ElPopularVale/LDL1A/README.md

Life Data Link vital signs monitor project files.
