ElPopularVale/LDL1A/Lifedatalink_v1_revA.kicad_pcb

## KiCad design Lifedatalink_v1_revA.kicad_pcb (2020-07-07)

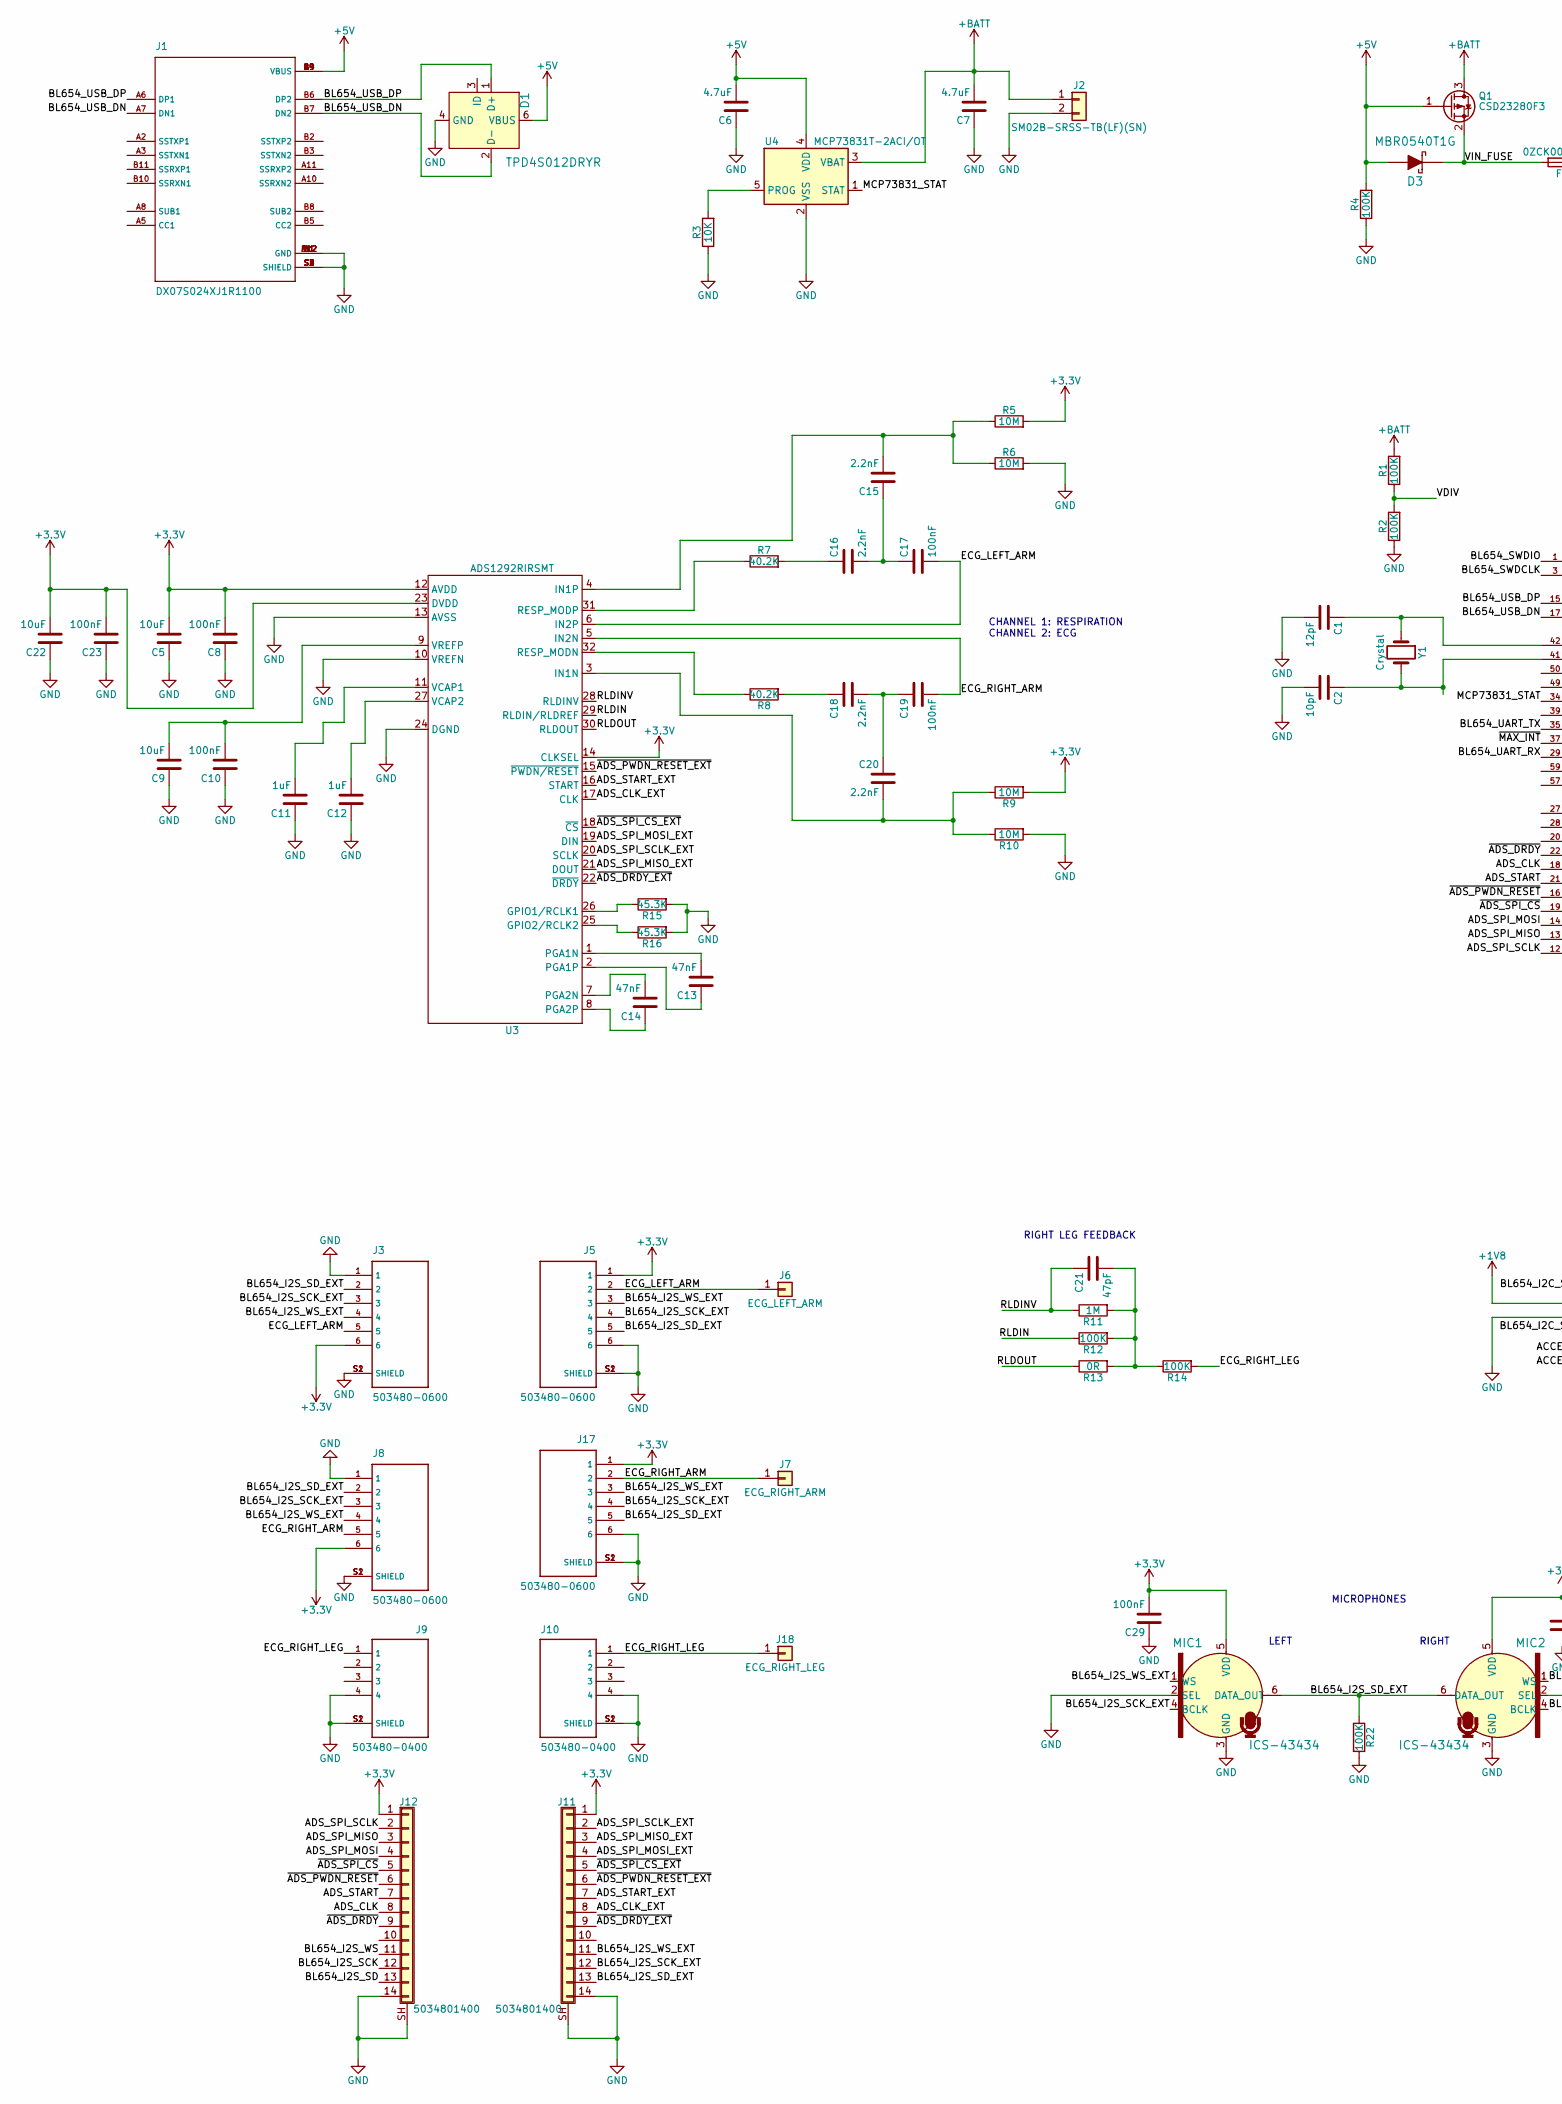
[picture p1: schematic Lifedatalink_v1_revA.kicad_sch, LifeDataLink, part in row 1, column 1]

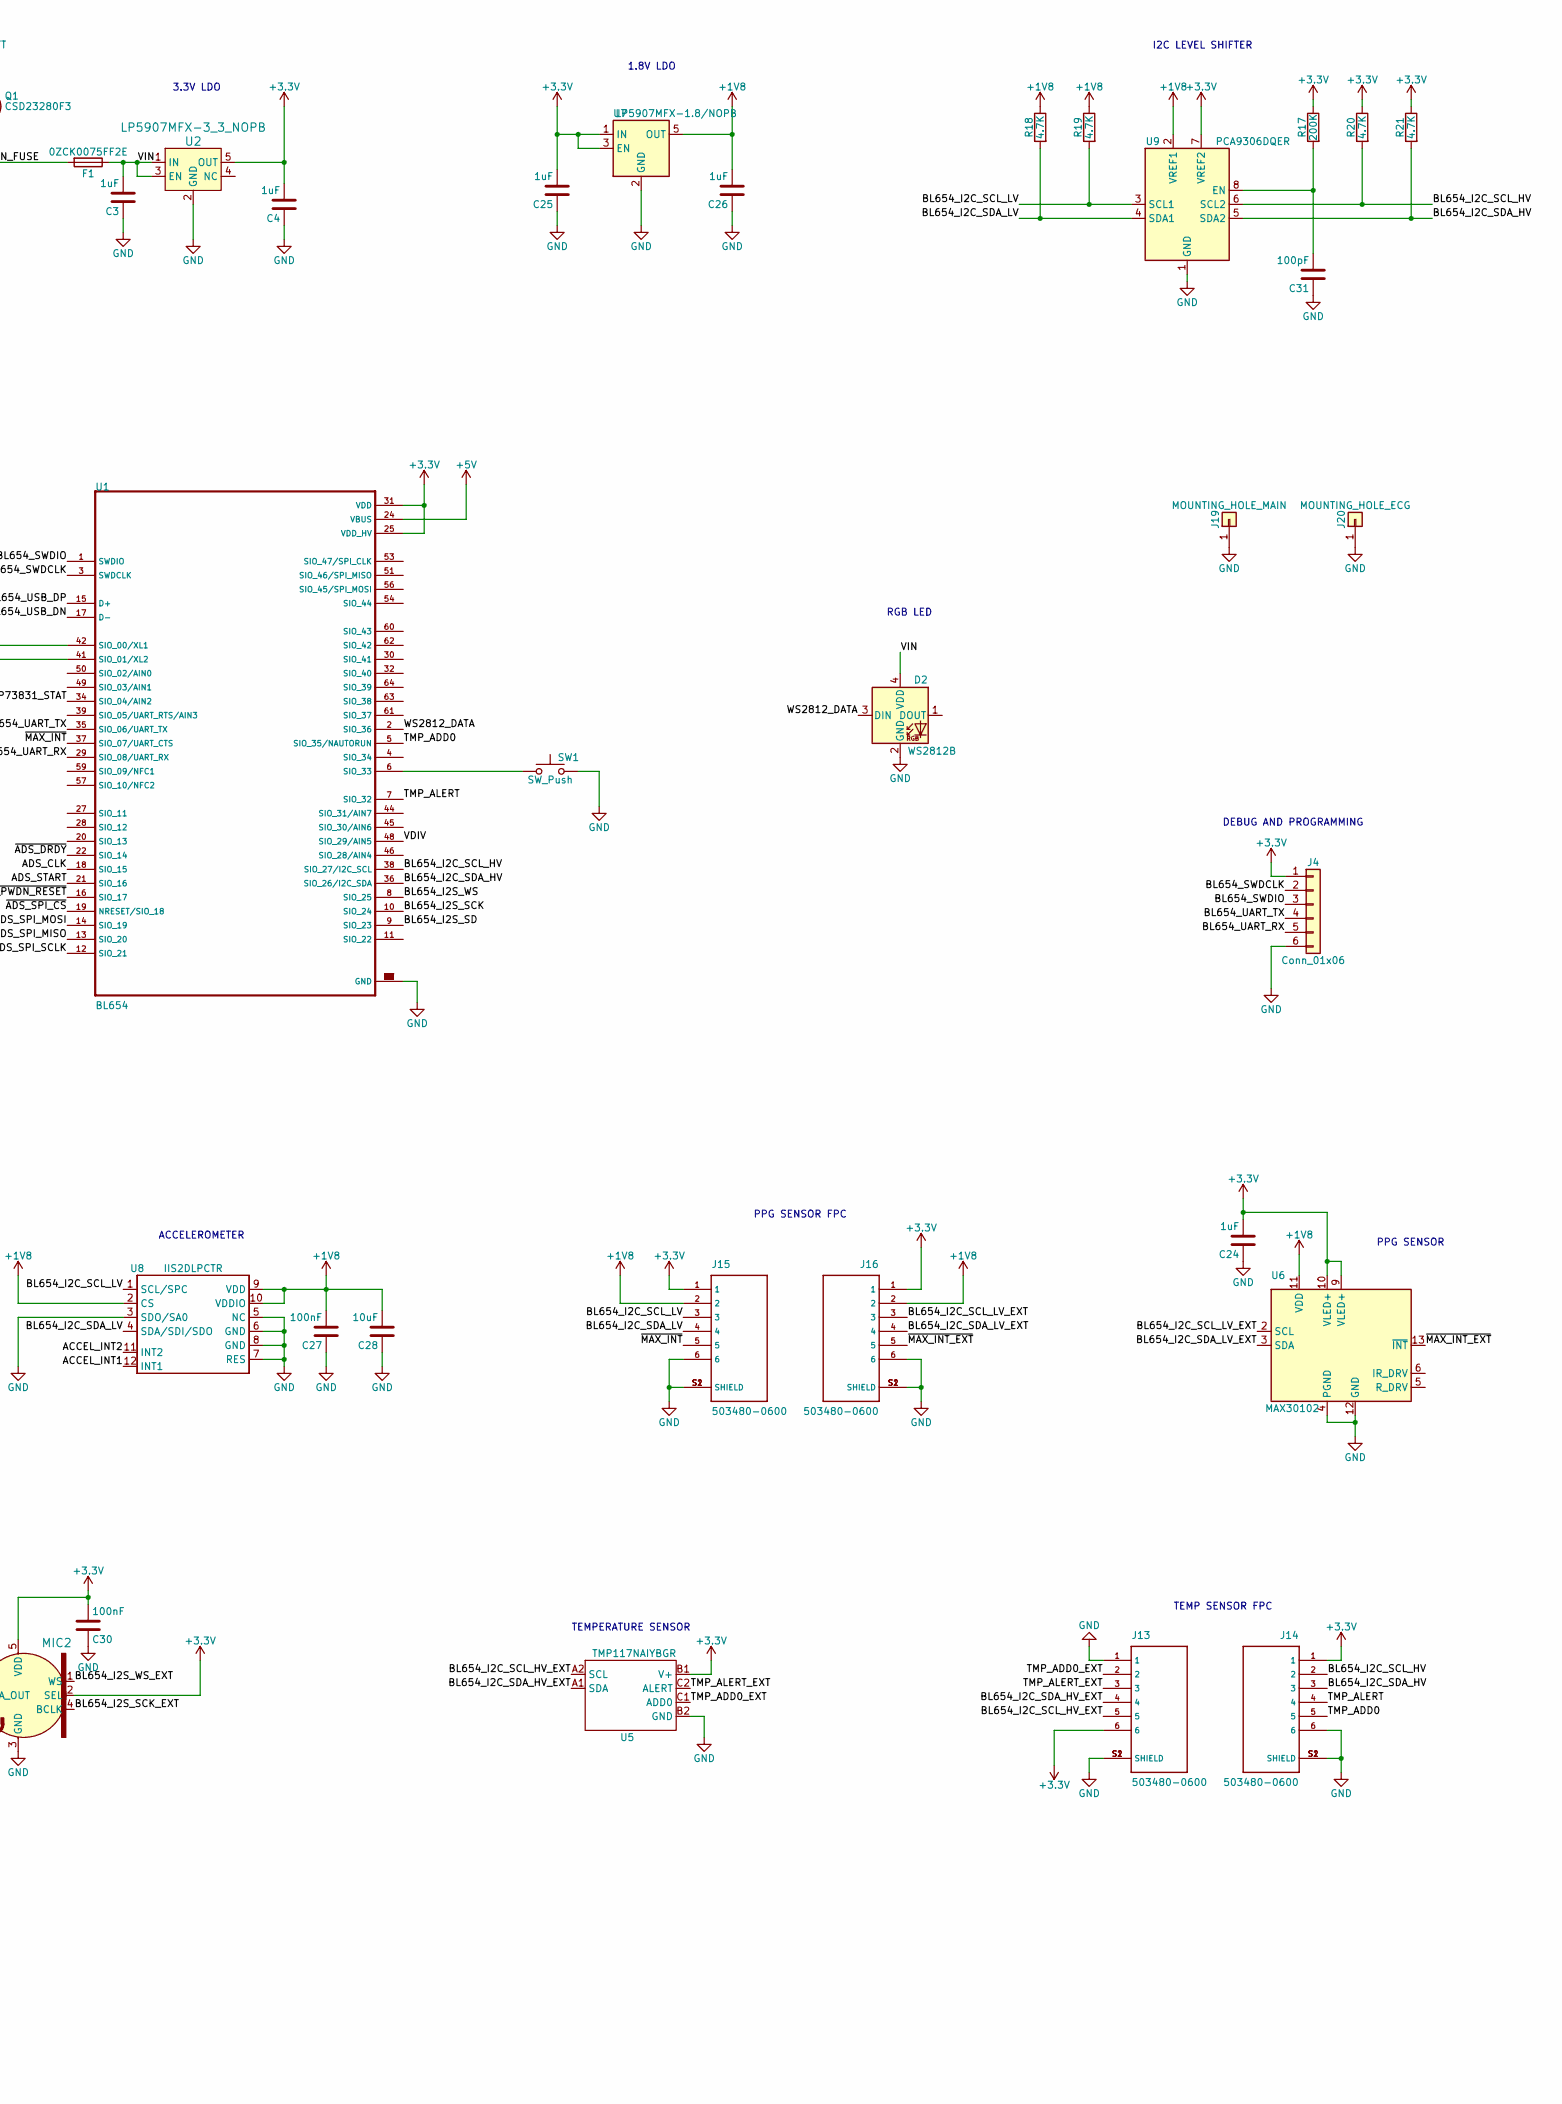
[picture p2: schematic Lifedatalink_v1_revA.kicad_sch, LifeDataLink, part in row 1, column 2]

Parts:
C1: 12pF; C_0402_1005Metric; MPN C0402C120J5GACTU
C2: 10pF; C_0402_1005Metric; MPN C0402C100J5GACTU
C3, C4, C11, C12, C24, C25, C26: 1uF; C_0402_1005Metric; MPN C0402C105K9PACTU
C5, C9, C22, C28: 10uF; C_0402_1005Metric; MPN C0402C106M9PAC7867
C6, C7: 4.7uF; C_0402_1005Metric; MPN C0402C475M7PACTU
C8, C10, C17, C19, C23, C27, C29, C30: 100nF; C_0402_1005Metric; MPN C0402C104K4PACTU
C13, C14: 47nF; C_0402_1005Metric; MPN C0402C473K3RACAUTO
C15, C16, C18, C20: 2.2nF; C_0402_1005Metric; MPN C0402C222K5RACTU
C21: 47pF; C_0402_1005Metric; MPN C0402C470K5GACTU
C31: 100pF; C_0402_1005Metric; MPN C0402C101J5GACTU
D1: TPD4S012DRYR; SON50P100X145X60-6N; MPN TPD4S012DRYR; Digi-Key_PN 296-24244-1-ND
D2: WS2812B; LED_WS2812-2020; MPN APA-102-2020
D3: MBR0540T1G; D_SOD-123; MPN MBR0540T1G; Digi-Key_PN MBR0540T1GOSCT-ND
F1: 0ZCK0075FF2E; Fuse_0805_2012Metric; MPN 0603L075SLYR
J1: DX07S024XJ1R1100; JAE_DX07S024XJ1R1100; MPN DX07S024XJ1R1100
J2: SM02B-SRSS-TB(LF)(SN); JST_SH_SM02B-SRSS-TB_1x02-1MP_P1.00mm_Horizontal; MPN SM02B-SRSS-TB(LF)(SN)
J3, J5, J8, J13, J14, J15, J16, J17: 503480-0600; MOLEX_503480-0600; MPN 503480-0600
J4: Conn_01x06; 1.27mm_pads_01x06
J6: ECG_LEFT_ARM; ECG_SNAP
J7: ECG_RIGHT_ARM; ECG_SNAP
J9, J10: 503480-0400; MOLEX_503480-0400; MPN 503480-0400
J11, J12: 5034801400; MPN 503480-1400
J18: ECG_RIGHT_LEG; ECG_SNAP
J19: MOUNTING_HOLE_MAIN; MountingHole_2.2mm_M2_DIN965_Pad
J20: MOUNTING_HOLE_ECG; MountingHole_2.2mm_M2_DIN965_Pad
MIC1, MIC2: ICS-43434; SPH0645LM4H-B; MPN ICS-43434
Q1: CSD23280F3; TRANS_CSD23280F3; MPN CSD23280F3
R1, R2, R4, R12, R14, R22: 100K; R_0402_1005Metric; MPN CRCW0402100KFKEDC
R3: 10K; R_0402_1005Metric; MPN CRCW040210K0FKEDC
R5, R6, R9, R10: 10M; R_0402_1005Metric; MPN CRCW040210M0FKED
R7, R8: 40.2K; R_0402_1005Metric; MPN CRCW040240K2FKEDC
R11: 1M; R_0402_1005Metric; MPN CRCW04021M00FKEDC
R13: 0R; R_0402_1005Metric; MPN CRCW04020000Z0EDC
R15, R16: 45.3K; R_0402_1005Metric; MPN RC0402FR-0745K3L
R17: 200K; R_0402_1005Metric; MPN RC0402FR-07200KL
R18, R19, R20, R21: 4.7K; R_0402_1005Metric; MPN CRCW04024K70FKEDC
SW1: SW_Push; SW_B3U-3000P; MPN B3U-3000P
U1: BL654; XCVR_451-00001; MPN BL654
U2: LP5907MFX-3_3_NOPB; SOT-23-5; MPN LP5907MFX-3.3/NOPB; Digi-Key_PN 296-38557-1-ND
U3: ADS1292RIRSMT; QFN-32-1EP_4x4mm_P0.4mm_EP2.9x2.9mm; MPN ADS1292RIRSMT
U4: MCP73831T-2ACI/OT; SOT-23-5; MPN MCP73831T-2ACI/OT
U5: TMP117NAIYBGR; Texas_DSBGA-6_0.9x1.4mm_Layout2x3_P0.5mm; MPN TMP117NAIYBGR
U6: MAX30102; Maxim_OLGA-14_3.3x5.6mm_P0.8mm; MPN MAX30102EFD+
U7: LP5907MFX-1.8/NOPB; SOT-23-5; MPN LP5907MFX-1.8/NOPB
U8: IIS2DLPCTR; LGA-12_2x2mm_P0.5mm; MPN IIS2DLPCTR
U9: PCA9306DQER; X2SON-8_1.4x1mm_P0.35mm; MPN PCA9306DQER
Y1: Crystal; ABS05-32.768KHZ-T; MPN ABS05-32.768KHZ-9-T

Connections:
+1V8: C26.2, C27.2, C28.2, J15.2, J16.2, R18.1, R19.1, U6.11 (VDD), U7.5 (OUT), U8.2 (CS), U8.9 (VDD), U8.10 (VDDIO), U9.2 (VREF1)
+3V3: C4.2, C5.2, C8.2, C22.2, C23.2, C24.2, C25.2, C29.2, C30.2, J3.6, J4.1, J5.1, J8.6, J11.1, J12.1, J13.6, J14.1, J15.1, J16.1, J17.1, MIC1.5 (VDD), MIC2.2 (SEL), MIC2.5 (VDD), R5.2, R9.2, R17.1, R20.1, R21.1, U1.25 (VDD_HV), U1.31 (VDD), U2.5 (OUT), U3.12 (AVDD), U3.14 (CLKSEL), U3.23 (DVDD), U5.B1 (V+), U6.9 (VLED+), U6.10 (VLED+), U7.1 (IN), U7.3 (EN), U9.7 (VREF2)
+5V: C6.2, D1.6 (VBUS), D3.2, J1.A4 (VBUS), J1.A9 (VBUS), J1.B4 (VBUS), J1.B9 (VBUS), Q1.1 (G), R4.2, U1.24 (VBUS), U4.4 (VDD)
+BATT: C7.2, J2.1, Q1.3 (D), R1.2, U4.3 (VBAT)
/ACCEL_INT1: U8.12 (INT1)
/ACCEL_INT2: U8.11 (INT2)
/ADS_CLK: J12.8, U1.18 (SIO_15)
/ADS_CLK_EXT: J11.8, U3.17 (CLK)
/ADS_SPI_MISO: J12.3, U1.13 (SIO_20)
/ADS_SPI_MISO_EXT: J11.3, U3.21 (DOUT)
/ADS_SPI_MOSI: J12.4, U1.14 (SIO_19)
/ADS_SPI_MOSI_EXT: J11.4, U3.19 (DIN)
/ADS_SPI_SCLK: J12.2, U1.12 (SIO_21)
/ADS_SPI_SCLK_EXT: J11.2, U3.20 (SCLK)
/ADS_START: J12.7, U1.21 (SIO_16)
/ADS_START_EXT: J11.7, U3.16 (START)
/BL654_I2C_SCL_HV: J14.2, R20.2, U1.38 (SIO_27/I2C_SCL), U9.6 (SCL2)
/BL654_I2C_SCL_HV_EXT: J13.5, U5.A2 (SCL)
/BL654_I2C_SCL_LV: J15.3, R19.2, U8.1 (SCL/SPC), U9.3 (SCL1)
/BL654_I2C_SCL_LV_EXT: J16.3, U6.2 (SCL)
/BL654_I2C_SDA_HV: J14.3, R21.2, U1.36 (SIO_26/I2C_SDA), U9.5 (SDA2)
/BL654_I2C_SDA_HV_EXT: J13.4, U5.A1 (SDA)
/BL654_I2C_SDA_LV: J15.4, R18.2, U8.4 (SDA/SDI/SDO), U9.4 (SDA1)
/BL654_I2C_SDA_LV_EXT: J16.4, U6.3 (SDA)
/BL654_I2S_SCK: J12.12, U1.10 (SIO_24)
/BL654_I2S_SCK_EXT: J3.3, J5.4, J8.3, J11.12, J17.4, MIC1.4 (BCLK), MIC2.4 (BCLK)
/BL654_I2S_SD: J12.13, U1.9 (SIO_23)
/BL654_I2S_SD_EXT: J3.2, J5.5, J8.2, J11.13, J17.5, MIC1.6 (DATA_OUT), MIC2.6 (DATA_OUT), R22.1
/BL654_I2S_WS: J12.11, U1.8 (SIO_25)
/BL654_I2S_WS_EXT: J3.4, J5.3, J8.4, J11.11, J17.3, MIC1.1 (WS), MIC2.1 (WS)
/BL654_SWDCLK: J4.2, U1.3 (SWDCLK)
/BL654_SWDIO: J4.3, U1.1 (SWDIO)
/BL654_UART_RX: J4.5, U1.29 (SIO_08/UART_RX)
/BL654_UART_TX: J4.4, U1.35 (SIO_06/UART_TX)
/BL654_USB_DN: D1.2 (D-), J1.A7 (DN1), J1.B7 (DN2), U1.17 (D-)
/BL654_USB_DP: D1.1 (D+), J1.A6 (DP1), J1.B6 (DP2), U1.15 (D+)
/ECG_LEFT_ARM: C17.2, J3.5, J5.2, J6.1, U3.6 (IN2P)
/ECG_RIGHT_ARM: C19.2, J7.1, J8.5, J17.2, U3.5 (IN2N)
/ECG_RIGHT_LEG: J9.1, J10.1, J18.1, R14.2
/MCP73831_STAT: U1.34 (SIO_04/AIN2), U4.1 (STAT)
/RLDIN: R12.1, U3.29 (RLDIN/RLDREF)
/RLDINV: C21.1, R11.1, U3.28 (RLDINV)
/RLDOUT: R13.1, U3.30 (RLDOUT)
/TMP_ADD0: J14.5, U1.5 (SIO_35/NAUTORUN)
/TMP_ADD0_EXT: J13.2, U5.C1 (ADD0)
/TMP_ALERT: J14.4, U1.7 (SIO_32)
/TMP_ALERT_EXT: J13.3, U5.C2 (ALERT)
/VDIV: R1.1, R2.2, U1.48 (SIO_29/AIN5)
/VIN: C3.2, D2.4 (VDD), F1.1, U2.1 (IN), U2.3 (EN)
/VIN_FUSE: D3.1, F1.2, Q1.2 (S)
/WS2812_DATA: D2.3 (DIN), U1.2 (SIO_36)
/~ADS_DRDY: J12.9, U1.22 (SIO_14)
/~ADS_DRDY_EXT: J11.9, U3.22 (~DRDY)
/~ADS_PWDN_RESET: J12.6, U1.16 (SIO_17)
/~ADS_PWDN_RESET_EXT: J11.6, U3.15 (~PWDN/RESET)
/~ADS_SPI_CS: J12.5, U1.19 (NRESET/SIO_18)
/~ADS_SPI_CS_EXT: J11.5, U3.18 (~CS)
/~MAX_INT: J15.5, U1.37 (SIO_07/UART_CTS)
/~MAX_INT_EXT: J16.5, U6.13 (~INT)
GND: C1.2, C2.2, C3.1, C4.1, C5.1, C6.1, C7.1, C8.1, C9.1, C10.1, C11.1, C12.1, C22.1, C23.1, C24.1, C25.1, C26.1, C27.1, C28.1, C29.1, C30.1, C31.1, D1.4 (GND), D2.2 (GND), J1.A1 (GND), J1.A12 (GND), J1.B1 (GND), J1.B12 (GND), J1.S1 (SHIELD), J1.S2 (SHIELD), J1.S3 (SHIELD), J1.S4 (SHIELD), J2.2, J3.1, J3.S1 (SHIELD), J3.S2 (SHIELD), J4.6, J5.6, J5.S1 (SHIELD), J5.S2 (SHIELD), J8.1, J8.S1 (SHIELD), J8.S2 (SHIELD), J9.4, J9.S1 (SHIELD), J9.S2 (SHIELD), J10.4, J10.S1 (SHIELD), J10.S2 (SHIELD), J11.14, J11.SH (Shield), J12.14, J12.SH (Shield), J13.1, J13.S1 (SHIELD), J13.S2 (SHIELD), J14.6, J14.S1 (SHIELD), J14.S2 (SHIELD), J15.6, J15.S1 (SHIELD), J15.S2 (SHIELD), J16.6, J16.S1 (SHIELD), J16.S2 (SHIELD), J17.6, J17.S1 (SHIELD), J17.S2 (SHIELD), J19.1, J20.1, MIC1.2 (SEL), MIC1.3 (GND), MIC2.3 (GND), R2.1, R3.1, R4.1, R6.2, R10.2, R15.2, R16.2, R22.2, SW1.2, U1.0 (GND), U1.23 (GND), U1.26 (GND), U1.33 (GND), U1.40 (GND), U1.43 (GND), U1.47 (GND), U1.52 (GND), U1.55 (GND), U1.58 (GND), U1.65 (GND), U1.66 (GND), U1.67 (GND), U1.68 (GND), U1.69 (GND), U1.70 (GND), U1.71 (GND), U2.2 (GND), U3.10 (VREFN), U3.13 (AVSS), U3.24 (DGND), U4.2 (VSS), U5.B2 (GND), U6.4 (PGND), U6.12 (GND), U7.2 (GND), U8.3 (SDO/SA0), U8.5 (NC), U8.6 (GND), U8.7 (RES), U8.8 (GND), U9.1 (GND)
unnamed: C1.1, U1.42 (SIO_00/XL1), Y1.1
unnamed: C2.1, U1.41 (SIO_01/XL2), Y1.2
unnamed: C9.2, C10.2, U3.9 (VREFP)
unnamed: C11.2, U3.11 (VCAP1)
unnamed: C12.2, U3.27 (VCAP2)
unnamed: C13.1, U3.2 (PGA1P)
unnamed: C13.2, U3.1 (PGA1N)
unnamed: C14.1, U3.8 (PGA2P)
unnamed: C14.2, U3.7 (PGA2N)
unnamed: C15.1, C16.2, C17.1
unnamed: C15.2, R5.1, R6.1, U3.4 (IN1P)
unnamed: C16.1, R7.2
unnamed: C18.1, R8.2
unnamed: C18.2, C19.1, C20.1
unnamed: C20.2, R9.1, R10.1, U3.3 (IN1N)
unnamed: C21.2, R11.2, R12.2, R13.2, R14.1
unnamed: C31.2, R17.2, U9.8 (EN)
unnamed: R3.2, U4.5 (PROG)
unnamed: R7.1, U3.31 (RESP_MODP)
unnamed: R8.1, U3.32 (RESP_MODN)
unnamed: R15.1, U3.26 (GPIO1/RCLK1)
unnamed: R16.1, U3.25 (GPIO2/RCLK2)
unnamed: SW1.1, U1.6 (SIO_33)

Notes on the sheet:
CHANNEL 1: RESPIRATION CHANNEL 2: ECG
RIGHT LEG FEEDBACK
LEFT
MICROPHONES
RIGHT
ACCELEROMETER
3.3V LDO
TEMPERATURE SENSOR
1.8V LDO
PPG SENSOR FPC
RGB LED
I2C LEVEL SHIFTER
TEMP SENSOR FPC
DEBUG AND PROGRAMMING
PPG SENSOR

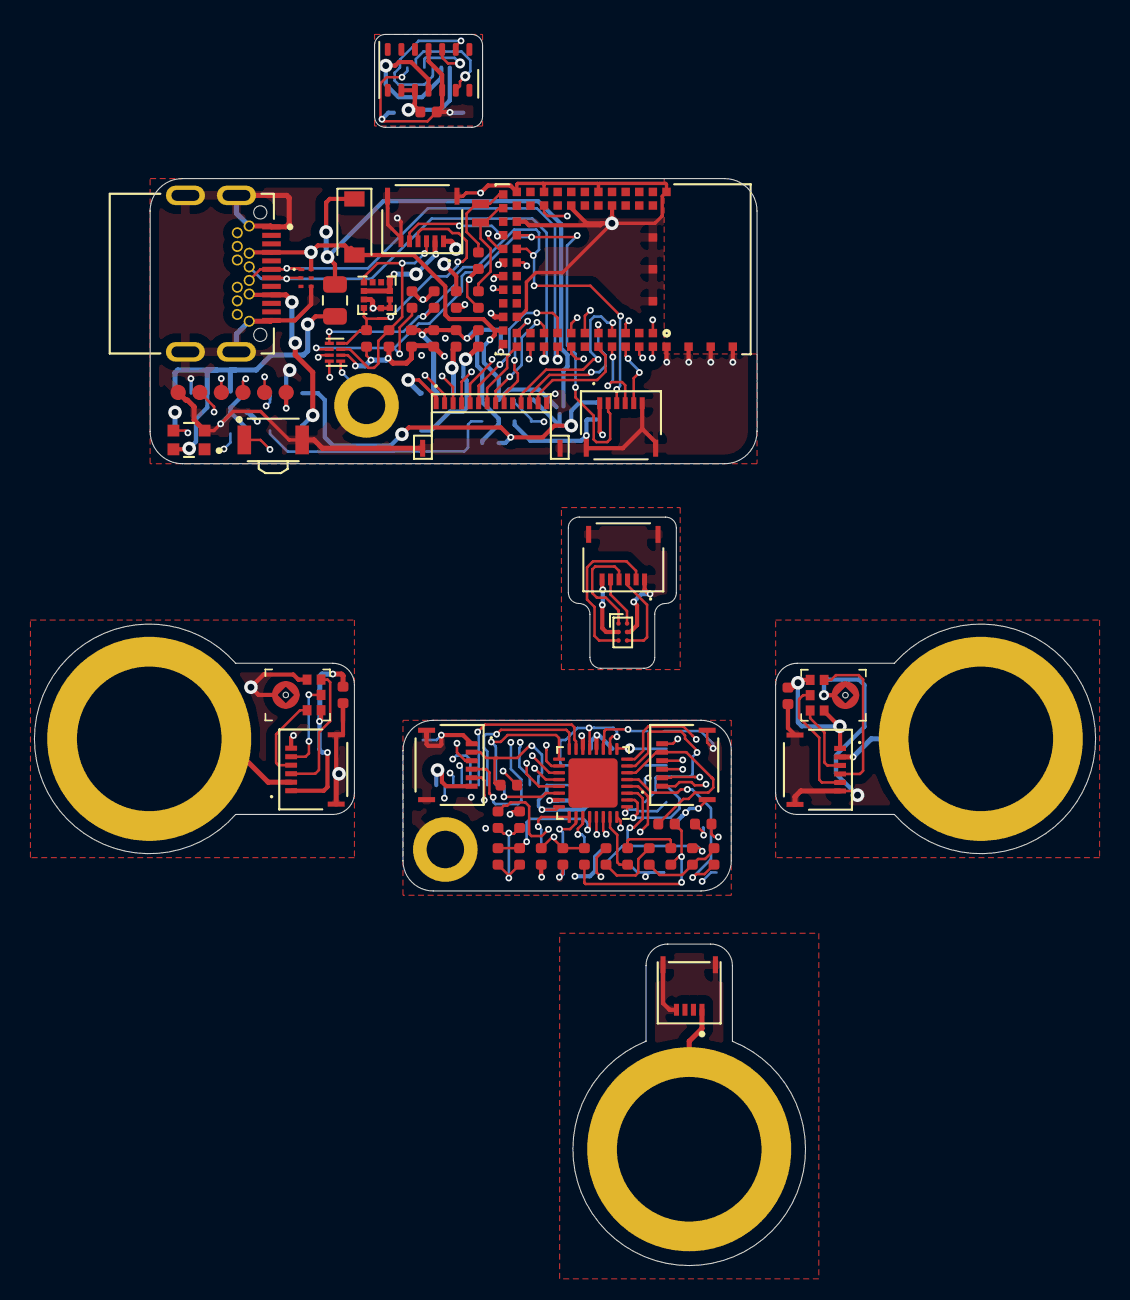
[picture p3: board Lifedatalink_v1_revA.kicad_pcb from above]

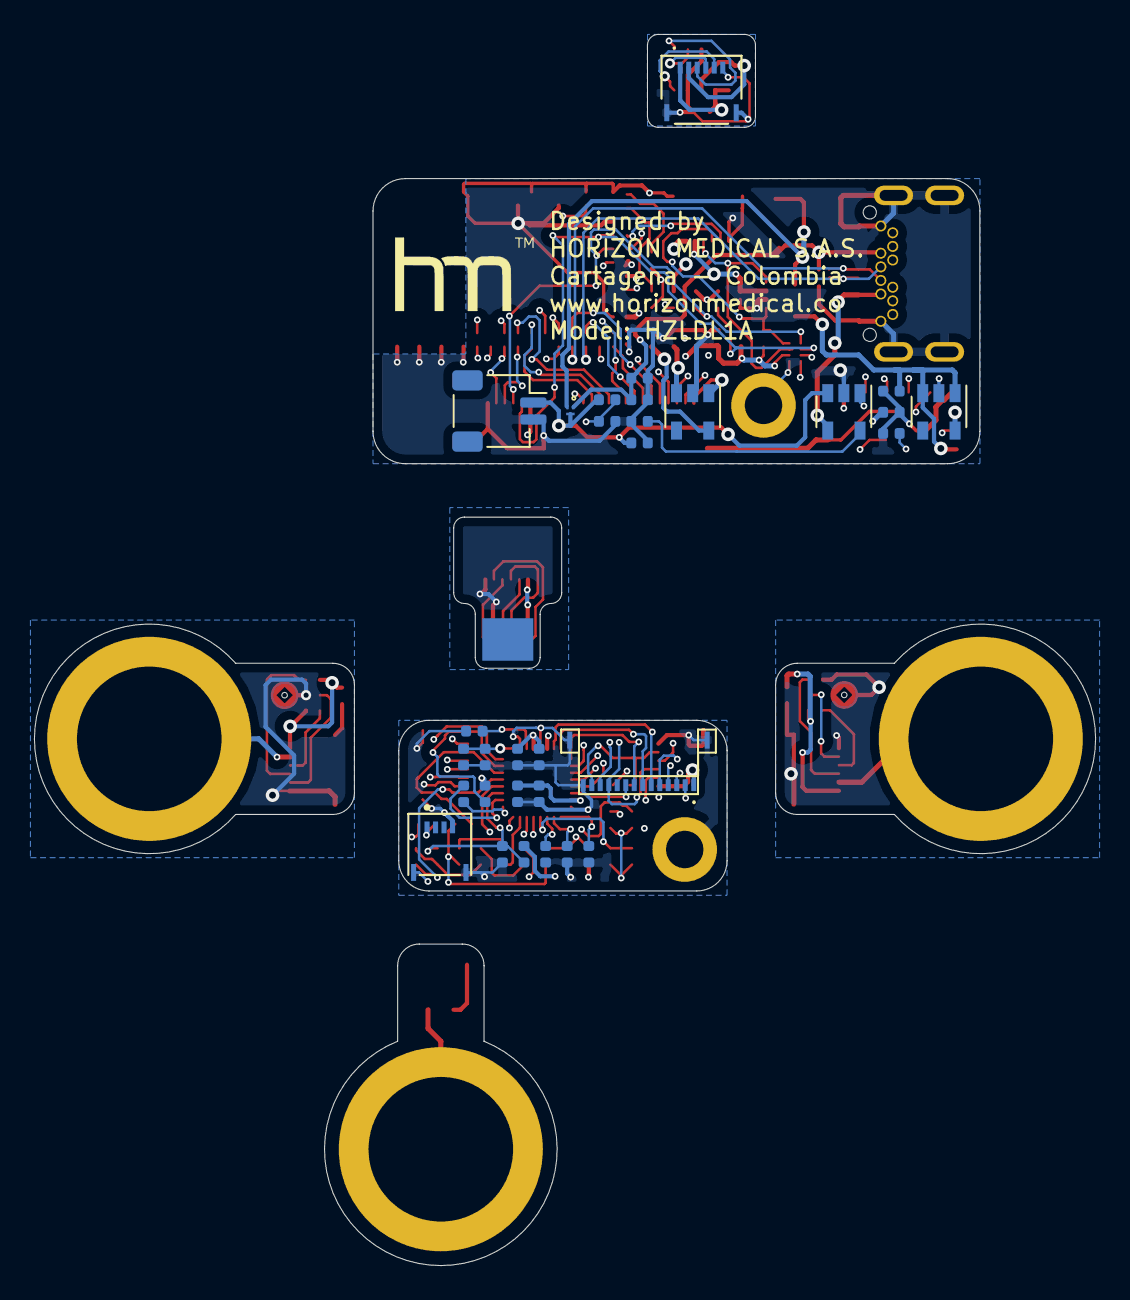
[picture p4: board Lifedatalink_v1_revA.kicad_pcb from below]

Board: 4 copper layers, 62.4 x 72.4 mm, 92 parts (32 on the bottom side), 81 nets.

Other parts of the board:
P6: HORIZON MEDICAL LOGO; horizon_logo_silk_small
