ElPopularVale/LDL1A/(commit log)

2020-03-28 Hexagonal PCB placed
    [Lifedatalink_v1_revA.kicad_pcb, Lifedatalink_v1_revA.sch]
2020-03-29 Cutted PCB placed and 3D models added
    [Lifedatalink_v1_revA.kicad_pcb]
2020-03-31 Added ECG snaps, microphones and other 3D models.
    [Lifedatalink_v1_revA.kicad_pcb, Lifedatalink_v1_revA.sch]
2020-04-01 Fixed LED and added JST connector to battery plus more 3D models
    [Lifedatalink_v1_revA.kicad_pcb, Lifedatalink_v1_revA.sch]
2020-04-01 Changed layout and added button
    [Lifedatalink_v1_revA.kicad_pcb, Lifedatalink_v1_revA.sch]
2020-04-04 Added board properties
    [Lifedatalink_v1_revA.kicad_pcb, Lifedatalink_v1_revA.sch]
2020-04-07 Main board routed
    [Lifedatalink_v1_revA.kicad_pcb, Lifedatalink_v1_revA.sch]
2020-04-09 Completed routing of all boards
    [Lifedatalink_v1_revA.kicad_pcb, Lifedatalink_v1_revA.sch]
2020-04-15 Fix temperature sensor thermal pad, mounting holes, silk screen, mic ground, capacitor symmetric location and routing
    [Lifedatalink_v1_revA.kicad_pcb, Lifedatalink_v1_revA.sch]
2020-04-19 Finished post routing schematic pinout and footprint cross check
    [Lifedatalink_v1_revA.kicad_pcb, Lifedatalink_v1_revA.sch]
2020-04-20 Added battery level voltage divider
    [Lifedatalink_v1_revA.kicad_pcb, Lifedatalink_v1_revA.sch]
2020-04-22 Changed the color of FFC connectors
    [Lifedatalink_v1_revA.kicad_pcb]
2020-04-22 Fixed electrode boards
    [Lifedatalink_v1_revA.kicad_pcb, Lifedatalink_v1_revA.sch]
2020-04-22 Fixed small routing traces
    [Lifedatalink_v1_revA.kicad_pcb]
2020-04-26 Finalized and exported CAD files for quotation
    [Lifedatalink_v1_revA-B_Cu.gbl, Lifedatalink_v1_revA-B_Mask.gbs, Lifedatalink_v1_revA-B_Paste.gbp, Lifedatalink_v1_revA-B_SilkS.gbo, Lifedatalink_v1_revA-Edge_Cuts.gm1, Lifedatalink_v1_revA-F_Cu.gtl, Lifedatalink_v1_revA-F_Mask.gts, Lifedatalink_v1_revA-F_Paste.gtp]
2020-04-30 Finalized and exported CAD for manufacturing including Fab layers
    [Lifedatalink_v1_revA-B_Cu.gbl, Lifedatalink_v1_revA-B_Fab.gbr, Lifedatalink_v1_revA-B_Mask.gbs, Lifedatalink_v1_revA-B_Paste.gbp, Lifedatalink_v1_revA-B_SilkS.gbo, Lifedatalink_v1_revA-Edge_Cuts.gm1, Lifedatalink_v1_revA-F_Cu.gtl, Lifedatalink_v1_revA-F_Fab.gbr]
2020-05-19 Upgraded to Kicad nightly and exported schematic to Hackster.io contest
    [Lifedatalink_v1_revA.kicad_sch, Lifedatalink_v1_revA.sch]
2020-07-07 Add battery 3D model
    [Lifedatalink_v1_revA.kicad_pcb]
